Fri3dCamp/dj_2026/README.md

# dj_2026
The design files and software for the Fri3dcamp 2026 DJ addon

More info on the software can be found in the [Firmware](Firmware/README.md) subfolder.
