Fri3dCamp/dj_2026/Hardware/Fri3d_2026_DJ_00/OUTPUT/BOM/Bill of Materials-Fri3d_2026_DJ_00(Default).xls

Sheet: BOM Report
Bill of Materials |  |  | Fri3D 2026 DJ
Project: |  | Fri3d_2026_DJ_00.PrjPcb
Revision: |  | 00
Variant: |  | Default
Creation Date: | 19/12/2025 | 21:54
Print Date: | 2026-01-17 | 22:23:54
Footprint | Comment | LibRef | Designator | Value | Description | Supplier 1 | Supplier Part Number 1 | Supplier 2 | Supplier Part Number 2 | Supplier 3 | Supplier Part Number 3 | Quantity
C0603_N |  | CAP # 100nF 16V 0603 | C2, C9 | 100nF 16V | CAP # 100nF 16V 0603 | LCSC | C282519 |  |  | Generic | 100nF 16V 0603 X7R | 2
C0603_N |  | CAP # 1uF 16V 0603 | C5, C6 | 1uF 16V | CAP # 1uF 16V 0603 | Farnell | 2320814 | LCSC | C1592 | Generic | 1uF 16V 0603 X7R | 2
C0603_N |  | CAP # 100pF 50V 0603 | C22 | 100pF 50V | CAP # 100pF 50V 0603 | LCSC | C344186 | LCSC | C14665 | Generic | 100pF 50V 0603 | 1
CZ20_2x4 | Campzone 2020 2x4 silicone keypad | SW # CZ20 2x4 | CZ1 | CZ20 2x4 | SW # CZ20 2x4 | STOCK |  |  |  |  |  | 1
LED_5050_WS2812B_WHITE | WS2812 based digital RGB LED 5050 White package reduced current | LED # RGB WS2812C-5050 WH | D1, D2, D3, D4, D5, D6, D7, D8 | WS218C 5050 WH | LED # RGB WS2812C-5050 WH | Aliexpress | WS2812C Black 5050 | LCSC | C114587 |  |  | 8
DO-214AC_AC | 40V 2A 550mV@2A DO-214 Schottky | Schottky # SS24-MS | D9 | SS24-MS | Schottky # SS24-MS | LCSC | C2836395 |  |  |  |  | 1
XUNPU-TYPEC-304S-ACP16 | USB 2.0 C Reversible Receptacle Horizontal full SMD | USB # C 2.0 RCPT TYPEC-304S-ACP16 | J1 | TYPEC-304S-ACP16 | USB # C 2.0 RCPT TYPEC-304S-ACP16 | LCSC | C5187472 | LCSC | C2927040 | LCSC | C5156603 | 1
HDR2X6 | Header 6X2 | Pin Header 2.54mm dual row 12way | P1 |  | Pin Header 2.54mm dual row 12way |  |  |  |  |  |  | 1
HDR1X3 | Header 3 | Pin Header 2.54mm 3way | P2, P3 |  | Pin Header 2.54mm 3way | LCSC | C429954 | LCSC | C49257 |  |  | 2
ALPS_RK09K1130AAU | 10kΩ Rotary Potentiometers | RES VAR POT 10k RK09K1130AAU | R1, R2, R4, R5, R12, R13 | RK09K1130AAU | RES VAR POT 10k RK09K1130AAU | LCSC | C202373 | Mouser | 688-RK09K1130AAU |  |  | 6
ALPS_RS301111J00R | 50kΩ Slide Potentiometers | RES VAR SLIDE 50k RS301111J00R | R3, R6, R14 | RS301111J00R | RES VAR SLIDE 50k RS301111J00R | LCSC | C361172 |  |  |  |  | 3
R0603_N |  | RES # 10K 0603 | R7, R15, R16, R17, R18, R20, R22, R24 | 10K | RES # 10K 0603 | Farnell | 2502397 | LCSC | C25804 | Generic | 10K 1% 0603 | 8
R0603_N |  | RES # 0R 0603 | R8, R9 | 0R | RES # 0R 0603 | Farnell | 2447743 | LCSC | C95177 / C15402 | Generic | 0R 1% 0603 | 2
R0603_N |  | RES # 5K1 0603 | R10, R11 | 5K1 | RES # 5K1 0603 | Farnell | 2845922 | LCSC | C112314 | Generic | 5K1 1% 0603 | 2
R0603_N |  | RES # 1K 0603 | R19, R21, R23, R25 | 1K | RES # 1K 0603 | Farnell | 2689409 | LCSC | C21190 | Generic | 1K 1% 0603 | 4
WE_430181038816 | 4.5x4.5mm tact SMD H3,8mm | SW # TACT small 4.5x4.5mm SMD WS-TASV | SW2 | 430181038816 | SW # TACT small 4.5x4.5mm SMD WS-TASV | Wurth | 430181038816 | Mouser | 710-430181038816 | LCSC | C174049 | 1
SOT23-3 | -2.3A -20V P-Ch MOSFET Vgs -1V | SL2301 P-Ch MOSFET -2.3A -20Vds | T1 | SL2301 | SL2301 P-Ch MOSFET -2.3A -20Vds | LCSC | C181086 |  |  |  |  | 1
SOIC_N_14 | Quad, 30-V, 1-MHz operational amplifier | OP # LM324 | U1 | LM324 | OP # LM324 | LCSC | C2977086 | LCSC | C7432021 | LCSC | C19723736 | 1
SOT23-5 | 3V3 LDO 300mA 150mV | LDO # 3V3 300mA RT9078-33GJ5 | U2 | RT9078-33GJ5 | LDO # 3V3 300mA RT9078-33GJ5 | LCSC | C110427 |  |  |  |  | 1
QFN_28_4.0x4.0_P0.4 | WCH CH32X035G8U6 QFN28 RISC-V 32-bit MCU, 62KB Flash, 10KB RAM, USB PD | RISCV # CH32X035G8U6 | U6 | CH32X035G8U6 | RISCV # CH32X035G8U6 | LCSC | C7437027 |  |  |  |  | 1
 |  |  |  |  |  |  |  |  |  |  |  | 49
Approved |  | Notes

Sheet: Manual
LibRef | Designator | Description | Quantity | 5
CAP # 100nF 16V 0603 | C2, C9 | CAP # 100nF 16V 0603 | 2 | 10
CAP # 1uF 16V 0603 | C5, C6 | CAP # 1uF 16V 0603 | 2 | 10
CAP # 100pF 50V 0603 | C22 | CAP # 100pF 50V 0603 | 1 | 5
SW # CZ20 2x4 | CZ1 | SW # CZ20 2x4 | 1 | 5
LED # RGB WS2812C-5050 WH | D1, D2, D3, D4, D5, D6, D7, D8 | LED # RGB WS2812C-5050 WH | 8 | 40
Schottky # SS24-MS | D9 | Schottky # SS24-MS | 1 | 5
USB # C 2.0 RCPT TYPEC-304S-ACP16 | J1 | USB # C 2.0 RCPT TYPEC-304S-ACP16 | 1 | 5
Pin Header 2.54mm dual row 12way | P1 | Pin Header 2.54mm dual row 12way | 1 | 5
Pin Header 2.54mm 3way | P2, P3 | Pin Header 2.54mm 3way | 2 | 10
RES VAR POT 10k RK09K1130AAU | R1, R2, R4, R5, R12, R13 | RES VAR POT 10k RK09K1130AAU | 6 | 30
RES VAR SLIDE 50k RS301111J00R | R3, R6, R14 | RES VAR SLIDE 50k RS301111J00R | 3 | 15
RES # 10K 0603 | R7, R15, R16, R17, R18, R20, R22, R24 | RES # 10K 0603 | 8 | 40
RES # 0R 0603 | R8, R9 | RES # 0R 0603 | 2 | 10
RES # 5K1 0603 | R10, R11 | RES # 5K1 0603 | 2 | 10
RES # 1K 0603 | R19, R21, R23, R25 | RES # 1K 0603 | 4 | 20
SW # TACT small 4.5x4.5mm SMD WS-TASV | SW2 | SW # TACT small 4.5x4.5mm SMD WS-TASV | 1 | 5
SL2301 P-Ch MOSFET -2.3A -20Vds | T1 | SL2301 P-Ch MOSFET -2.3A -20Vds | 1 | 5
OP # LM324 | U1 | OP # LM324 | 1 | 5
LDO # 3V3 300mA RT9078-33GJ5 | U2 | LDO # 3V3 300mA RT9078-33GJ5 | 1 | 5
RISCV # CH32X035G8U6 | U6 | RISCV # CH32X035G8U6 | 1 | 5
