Fri3dCamp/dj_2026/Mechanical/Fri3d_2026_DJ_01.step

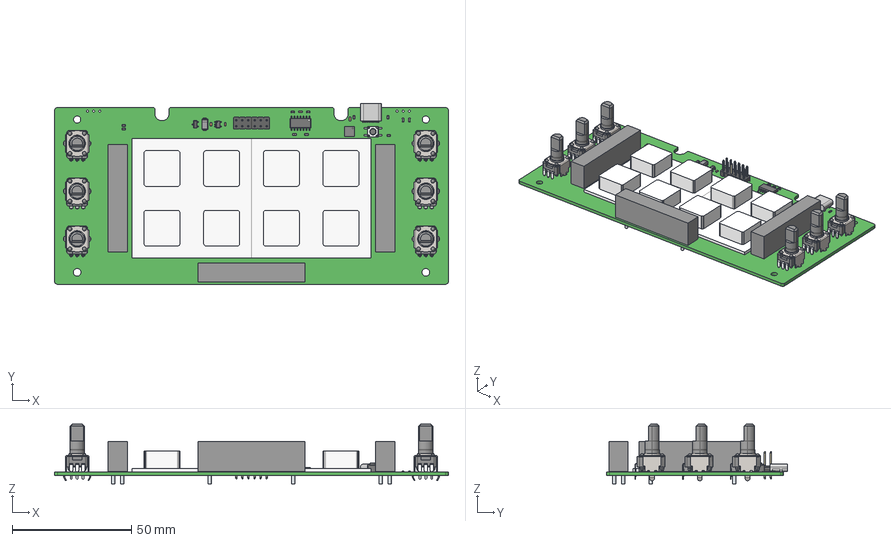
[picture p1: CAD file, 2026-08-19]
Mechanical/Fri3d_2026_DJ_01.step
165.0 x 75.6 x 24.9 mm
SOT-23A
C0603 x 4
SOIC_N_14
R0603 x 11
Leads x 9
RK09K1130AAU x 6
User Library-ws2812B-1 (1) x 8
Extruded x 10
User Library-SOT23-5-2
DO-214AC SMA
Thermal Shape
housing
pins x 4
HRO TYPE-C-31-M-12
HDR_2x3 x 2
