Fri3dCamp/dj_2026/Mechanical/slider.FCStd

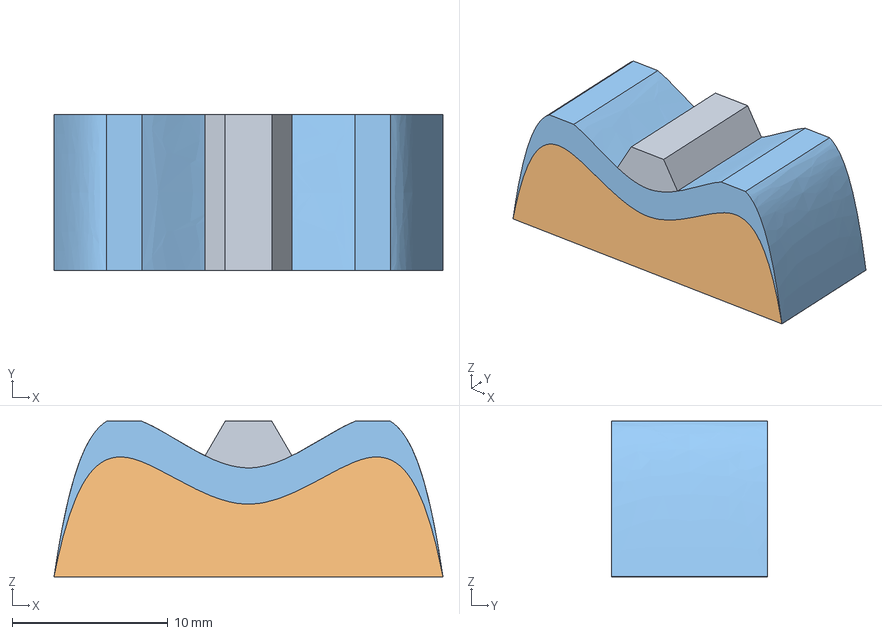
[picture p2: CAD file, 2026-08-07]
Mechanical/slider.FCStd
25.0 x 10.0 x 10.0 mm
Pointy Slider (left-right balance)
Indented Slider low (volume)
Indented Slider high (volume)
