Fri3dCamp/dj_2026/Mechanical/Slider_indented_high.00.stl

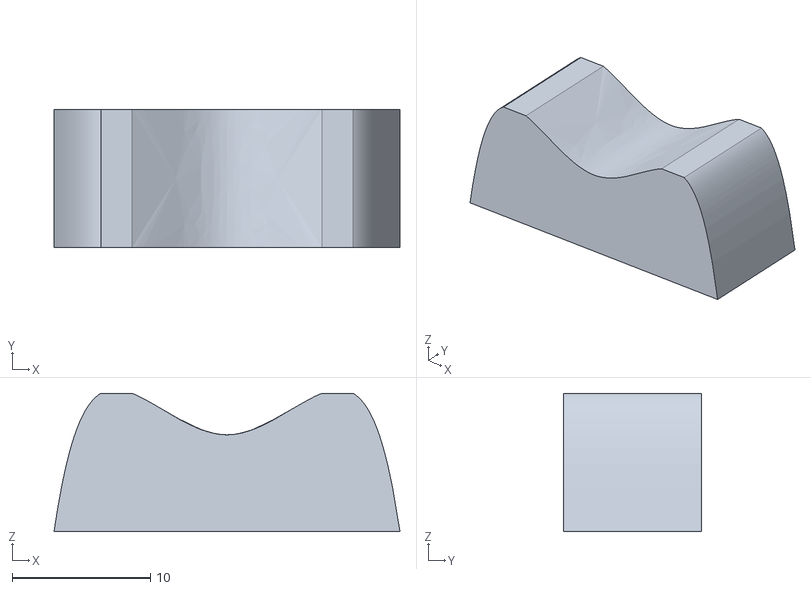
[picture p4: CAD file, 2026-08-07]
Mechanical/Slider_indented_high.00.stl
25.0 x 10.0 x 10.0
