Fri3dCamp/dj_2026/Mechanical/Slider_pointy.00.stl

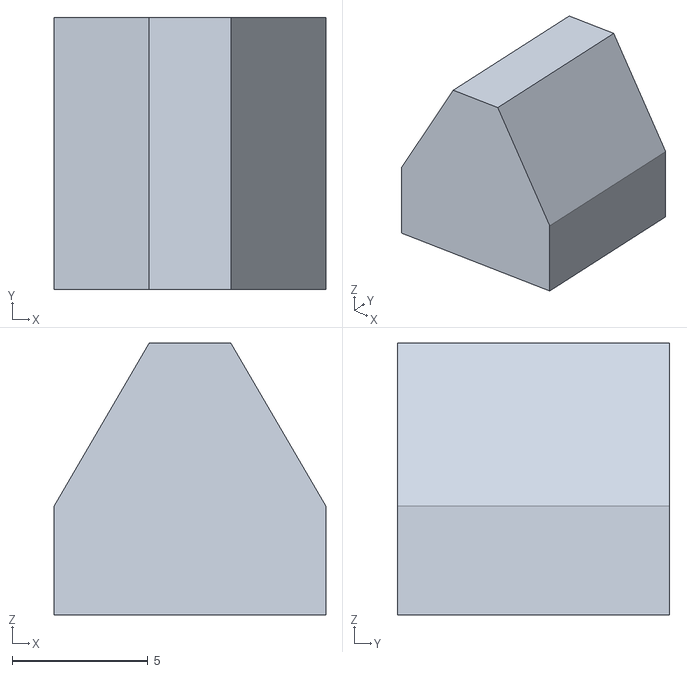
[picture p5: CAD file, 2026-08-07]
Mechanical/Slider_pointy.00.stl
10.0 x 10.0 x 10.0
