Fri3dCamp/dj_2026/Mechanical/Pot_knurled.00.stl

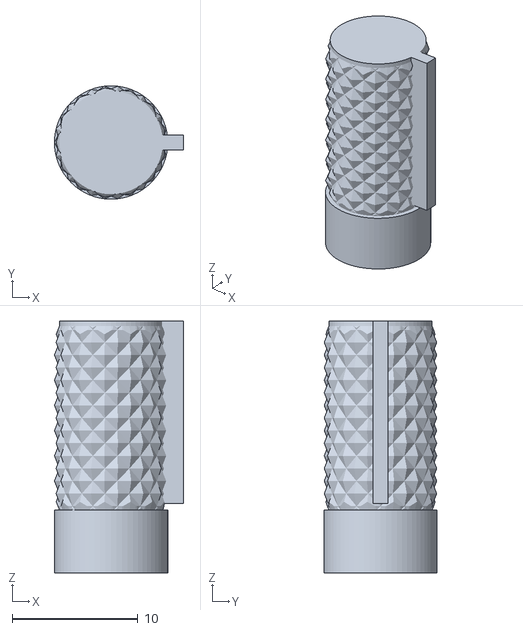
[picture p6: CAD file, 2026-06-03]
Mechanical/Pot_knurled.00.stl
10.2 x 9.00 x 20.0
