Fri3dCamp/dj_2026/(list of files, cad)

Other CAD files:
Mechanical/Pot_grooved.00.stl
