Fri3dCamp/dj_2026/Hardware/Fri3d_2026_DJ_00/OUTPUT/Fri3d_2026_DJ_00.PDF

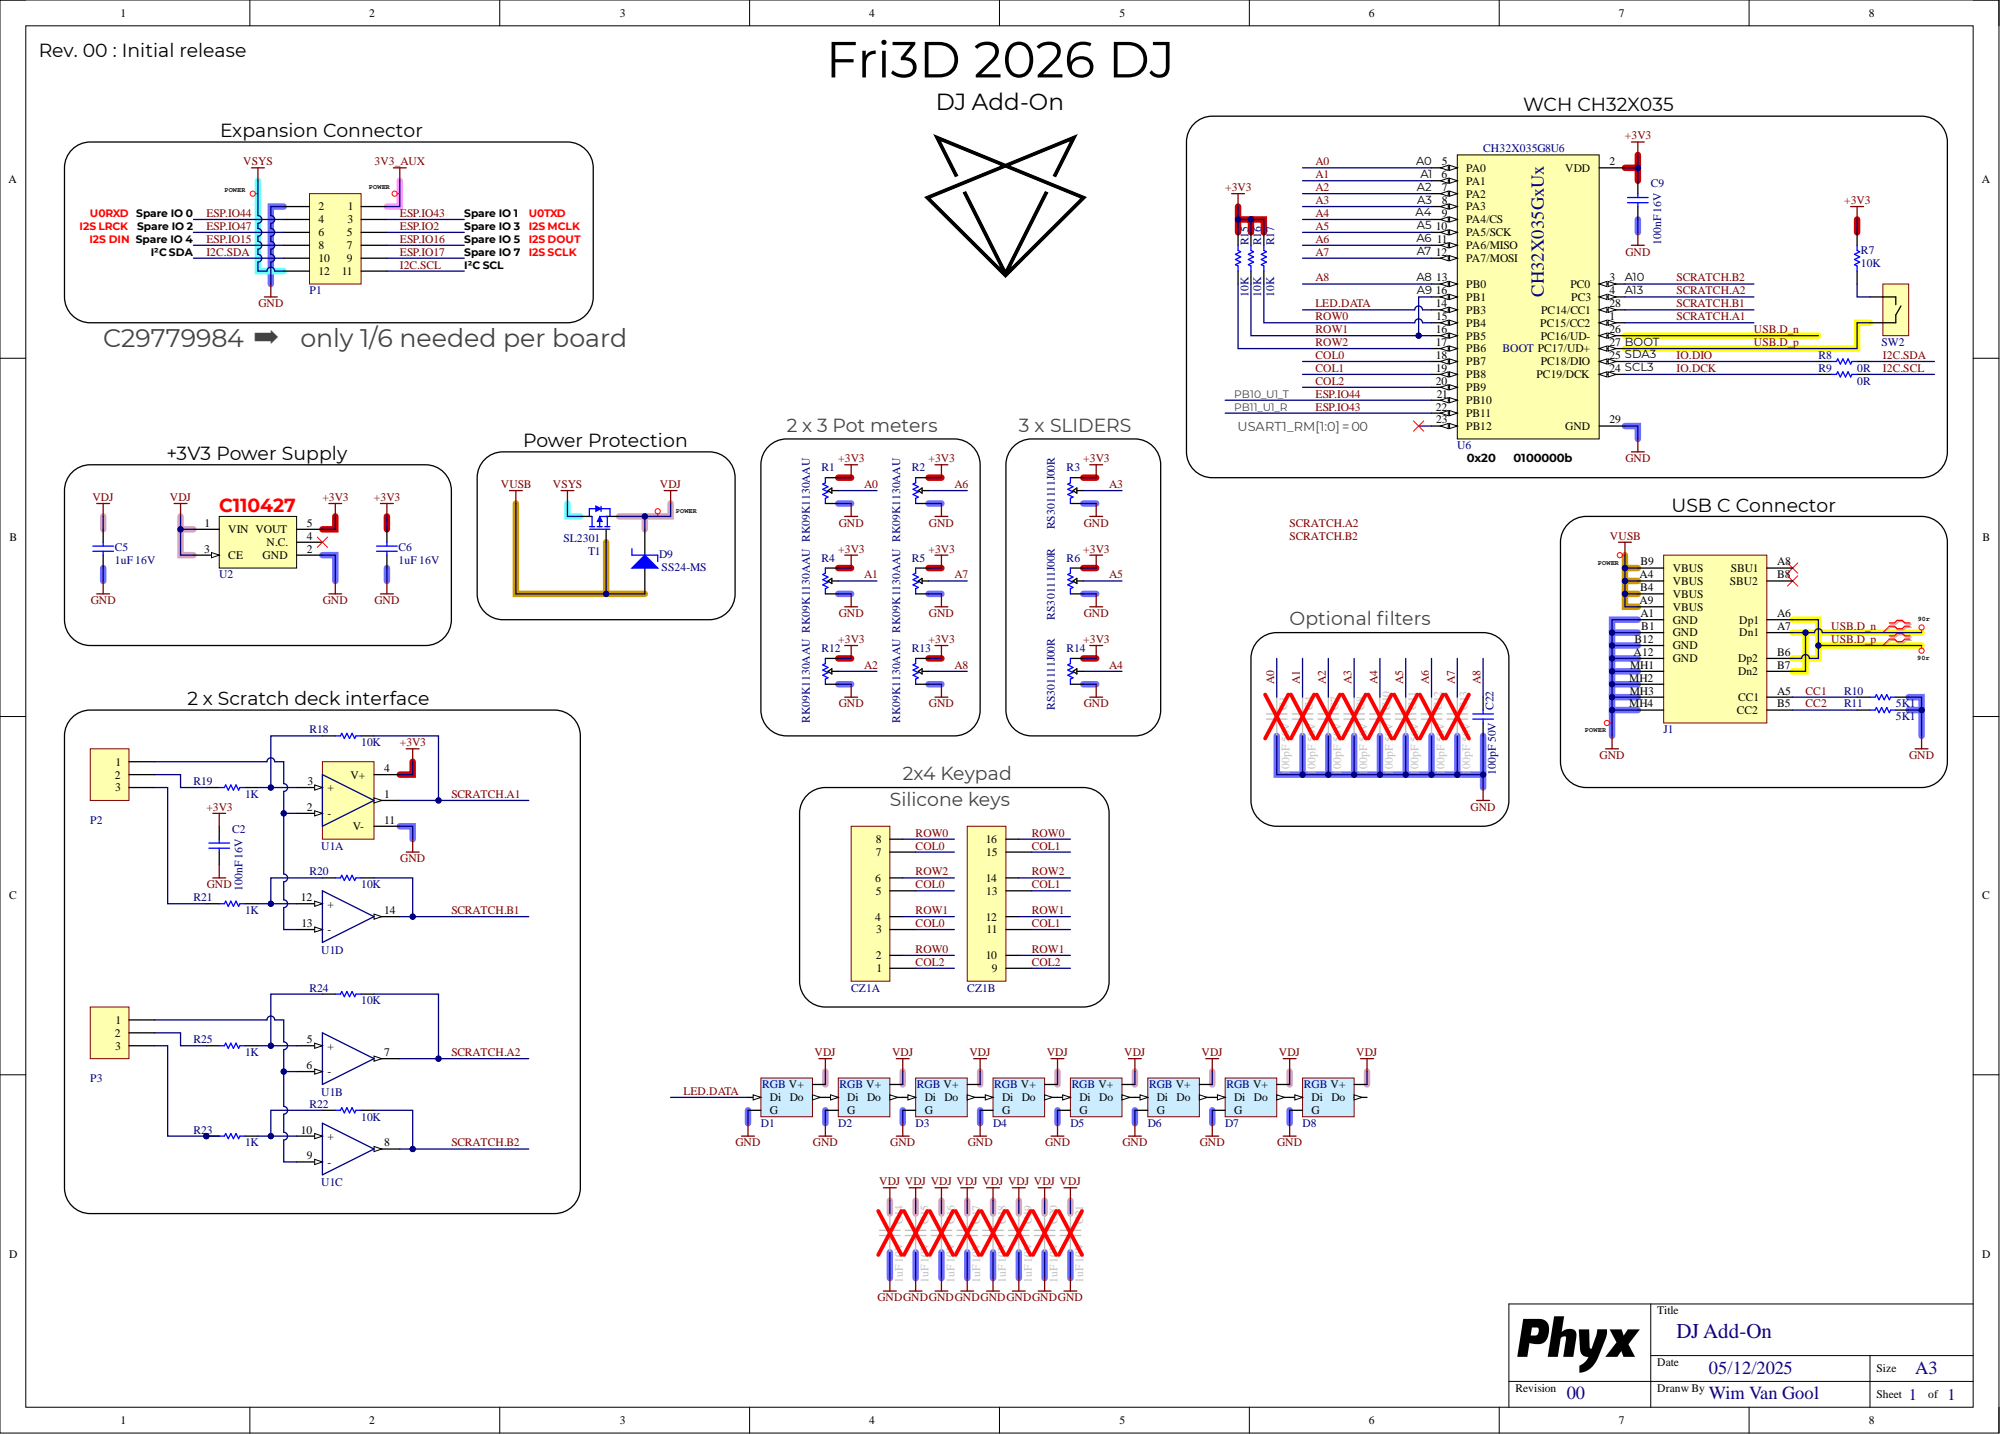
[picture p7: page 1]

Fri3D 2026 DJ Rev. 00 : Initial release

C29779984 ➡ only 1/6 needed per board

GND A12
MH1
MH2
MH3
MH4 | CC2 R11 5K1

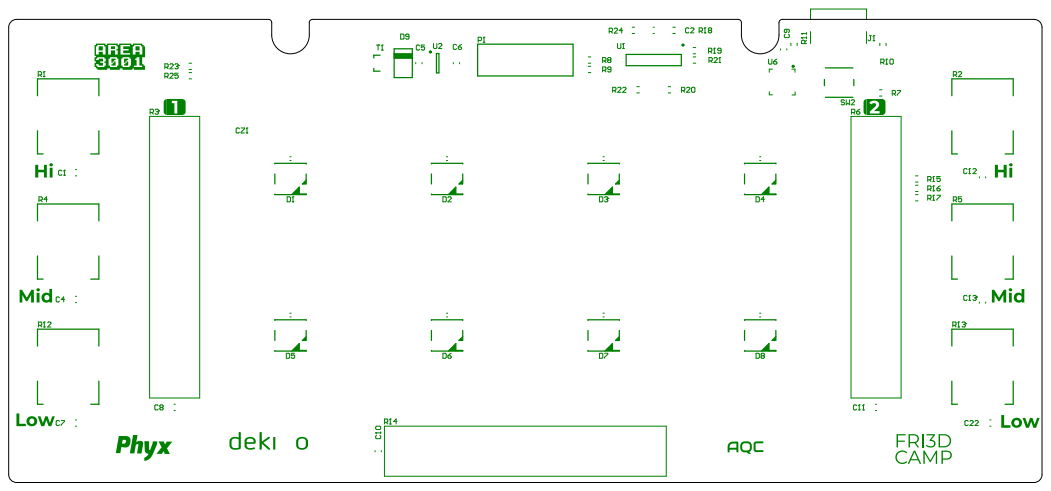
[picture p8: page 2]

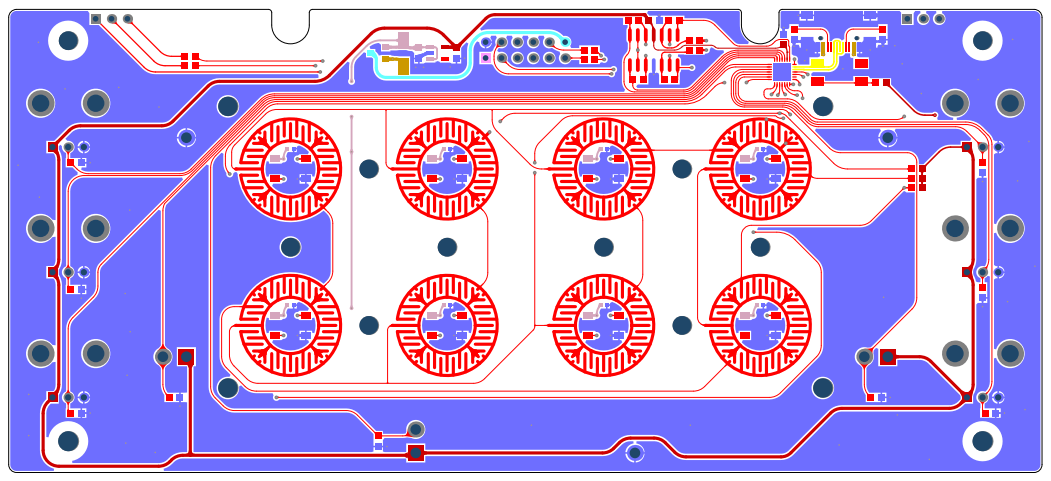
[picture p9: page 3]

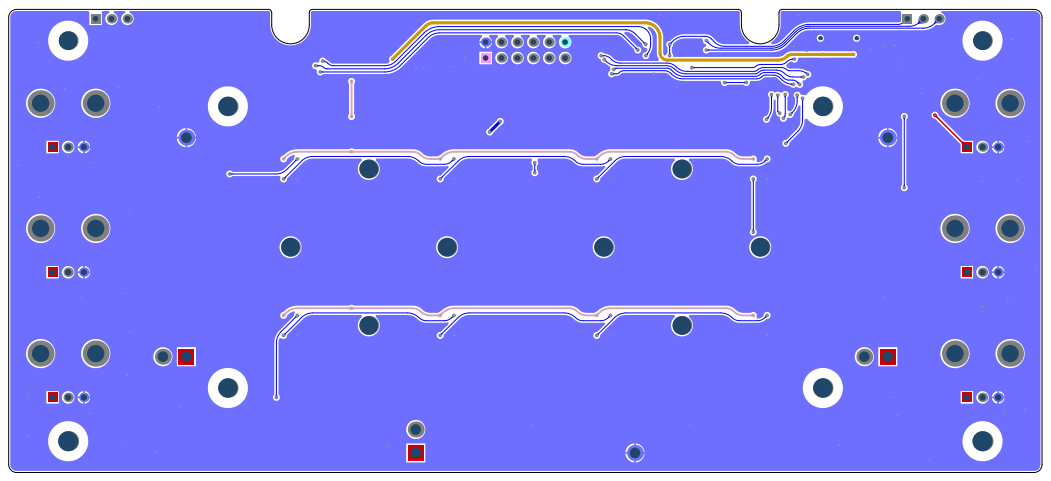
[picture p10: page 4]

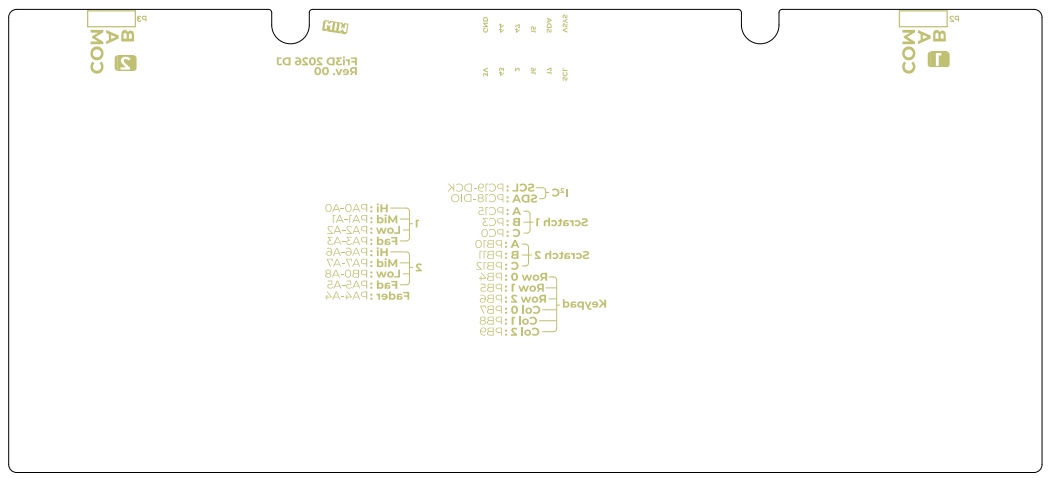
[picture p11: page 5]

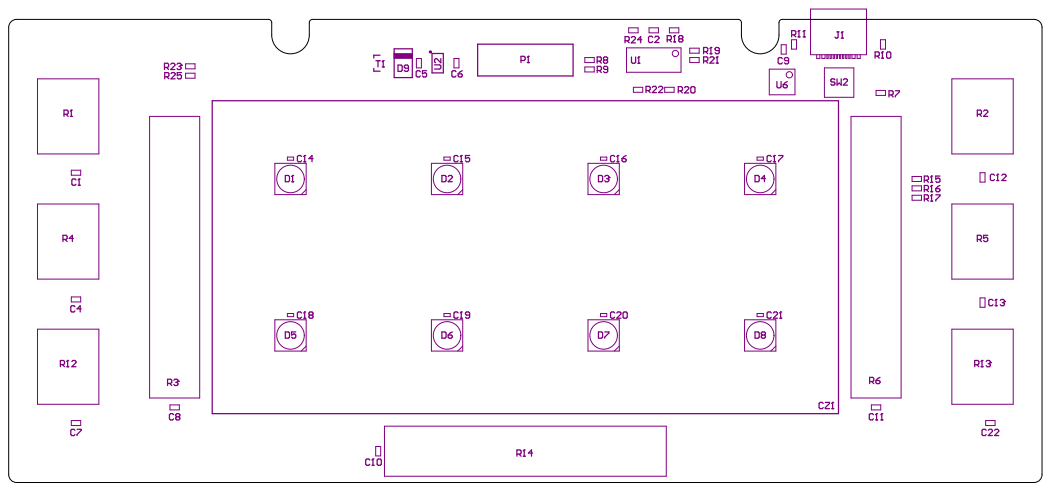
[picture p12: page 6]

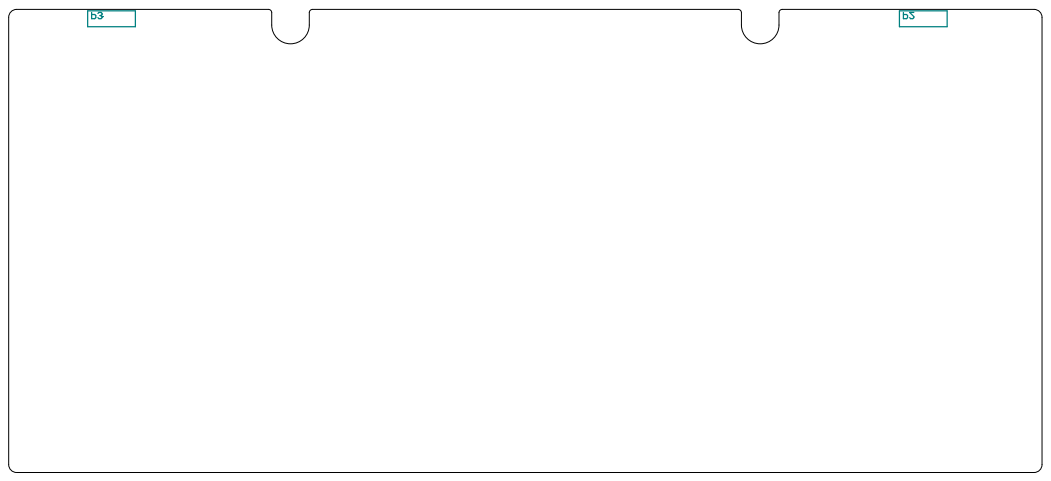
[picture p13: page 7]

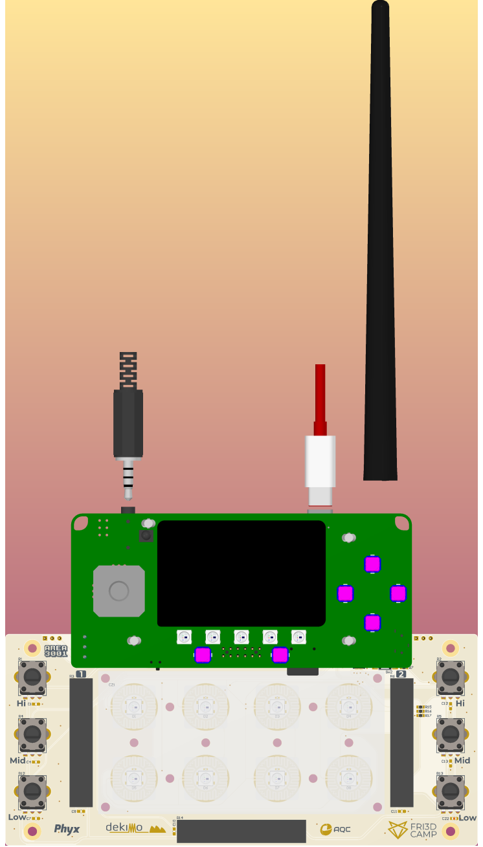
[picture p14: page 8]

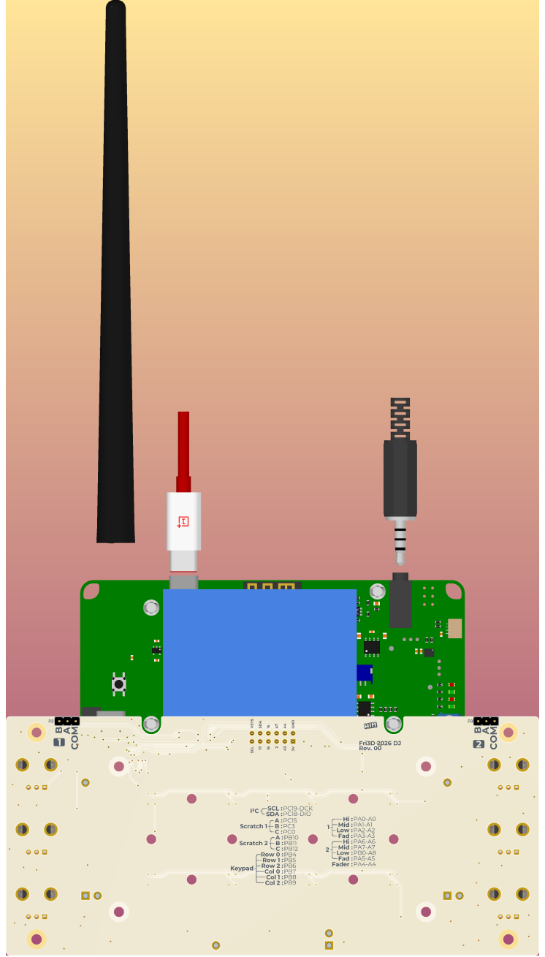
[picture p15: page 9]
