Fri3dCamp/dj_2026/(list of files, drawings)

Other design files:
Hardware/Fri3d_2026_DJ_00/Fri3d_2026_DJ_00.PrjPcb
Hardware/Fri3d_2026_DJ_00/Fri3d_2026_DJ_00.SchDoc
Hardware/Fri3d_2026_DJ_01/Fri3d_2026_DJ_01.PrjPcb
Hardware/Fri3d_2026_DJ_01/Fri3d_2026_DJ_01.SchDoc
