Fri3dCamp/dj_2026/(commit log)

2026-06-03 design files added
    [Bill of Materials-Fri3d_2026_DJ_00(Default).xls, Bill of Materials-Fri3d_2026_DJ_01(Default).xls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]
2026-06-19 add MIDI SysEx message support to control the LEDs
2026-07-22 last byte in MIDI range can only be 00–7F
2026-08-05 Add slider button designs and freecad source project. Pointy one for the left-right balance, indented one for volume (high and low variant depending on personal preference)
    [Slider_indented_high.00.stl, Slider_indented_low.00.stl, Slider_pointy.00.stl, slider.FCStd]
2026-08-10 apply i2c write fix from badge_expander
    [main.c]
2026-08-17 remove PRINT statement in the interrupt handler
2026-08-19 STEP 3D model of board added
    [Fri3d_2026_DJ_01.step]
